WilliTourt/Orbi-SpaceMouse/README.md

# Orbi-SpaceMouse
Orbi - Dual mode 6DOF CAD Mouse for smooth translating, rotating and scaling, emulates a 3Dconnexion spacemouse.

Developing...

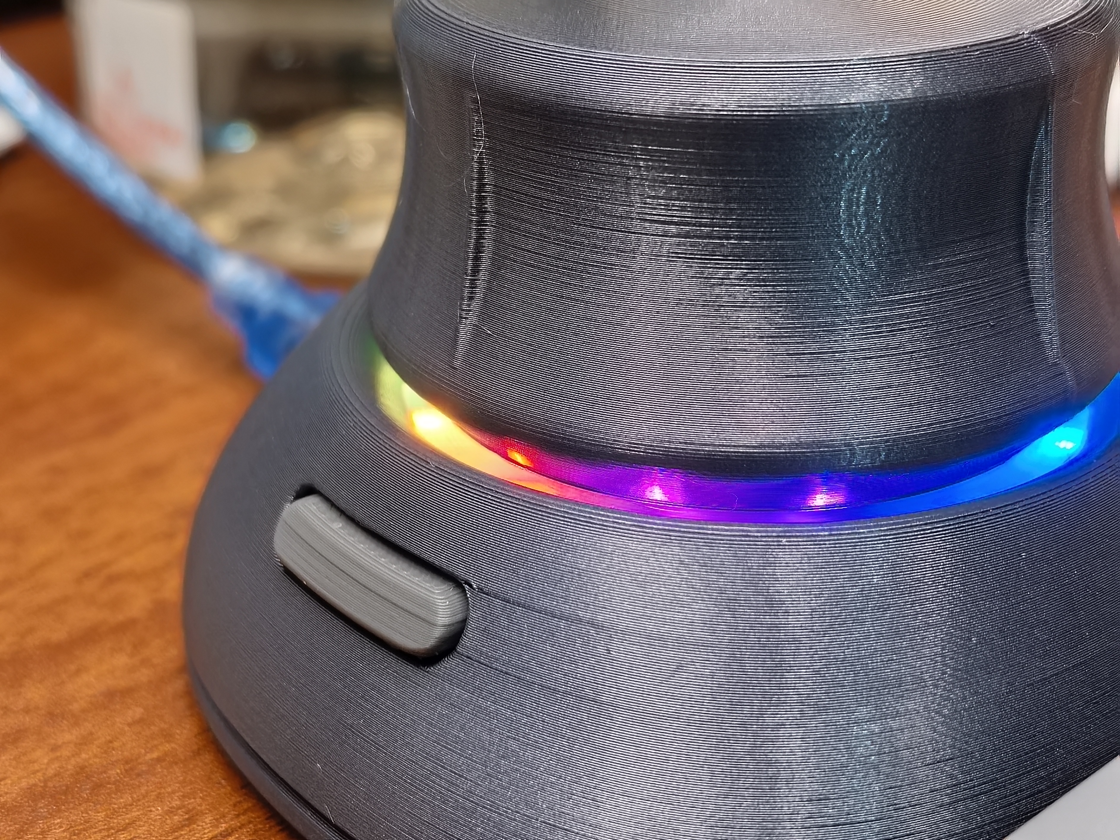
[picture p1: Orbi.jpg]
Orbi
