WilliTourt/Orbi-SpaceMouse/Hardware/PCB/Imgs/BottomBoard/Orbi BottomBoard  PCB 3D Bottom.png

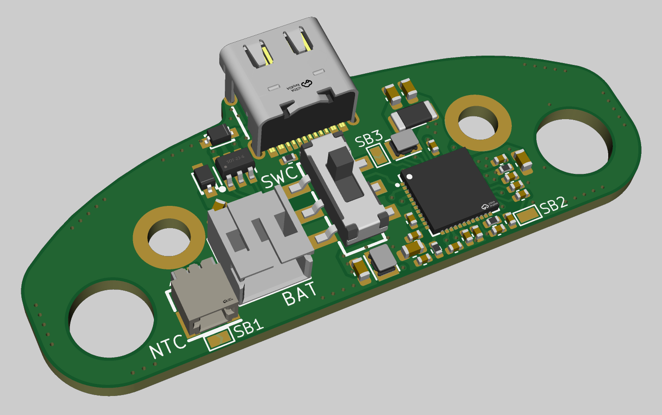
Hardware/PCB/Imgs/BottomBoard/Orbi BottomBoard PCB 3D Bottom.png
