WilliTourt/Orbi-SpaceMouse/Hardware/PCB/Imgs/BottomBoard/Orbi BottomBoard  PCB 3D Top.png

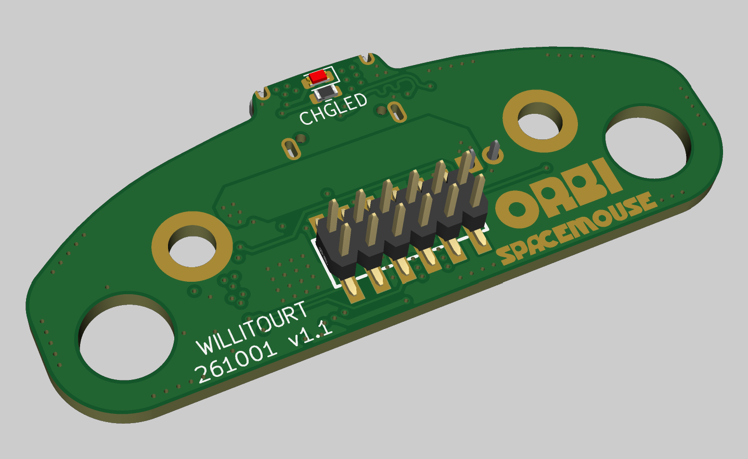
Hardware/PCB/Imgs/BottomBoard/Orbi BottomBoard PCB 3D Top.png
