WilliTourt/Orbi-SpaceMouse/Hardware/PCB/Imgs/BottomBoard/Orbi BottomBoard  PCB Bottom.png

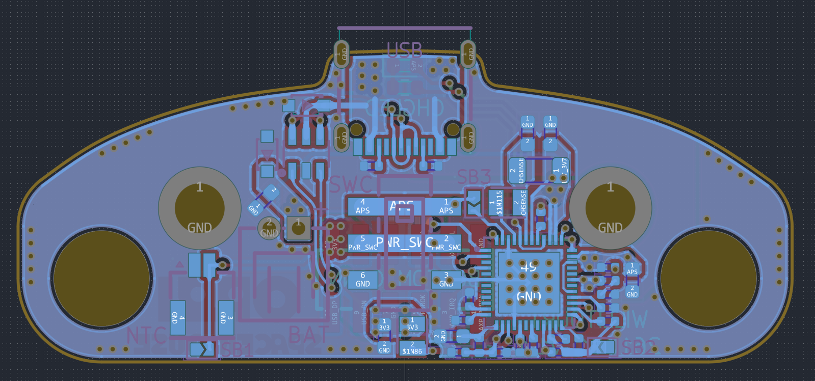
Hardware/PCB/Imgs/BottomBoard/Orbi BottomBoard PCB Bottom.png
