WilliTourt/Orbi-SpaceMouse/Hardware/PCB/Imgs/BottomBoard/Orbi BottomBoard  PCB Top.png

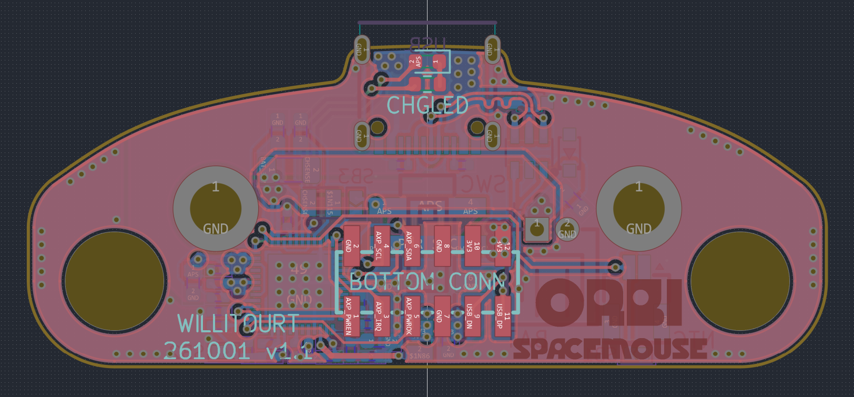
Hardware/PCB/Imgs/BottomBoard/Orbi BottomBoard PCB Top.png
