WilliTourt/Orbi-SpaceMouse/Hardware/PCB/Imgs/BottomBoard/Orbi BottomBoard Schem.png

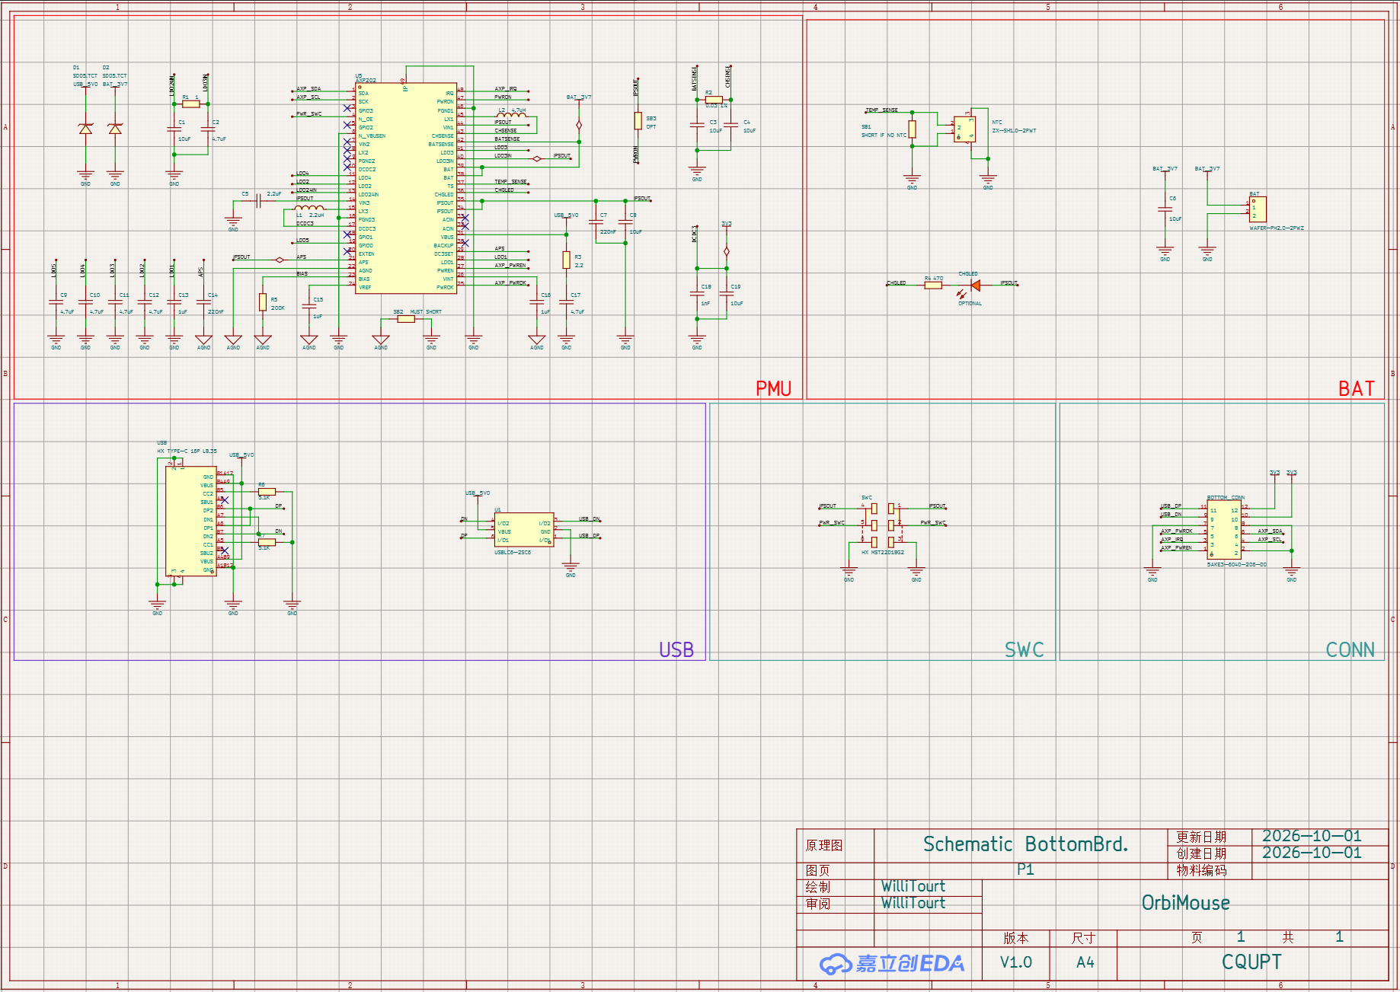
Hardware/PCB/Imgs/BottomBoard/Orbi BottomBoard Schem.png
