WilliTourt/Orbi-SpaceMouse/Hardware/PCB/Imgs/MomBoard/Orbi MomBoard  PCB 3D Bottom (Colorized Silkscreen).png

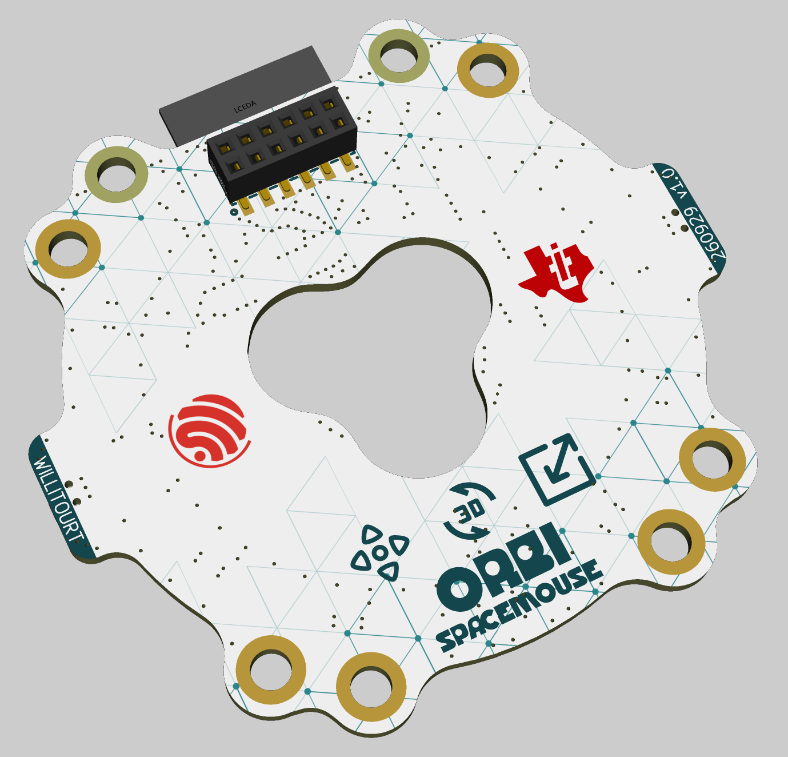
Hardware/PCB/Imgs/MomBoard/Orbi MomBoard PCB 3D Bottom (Colorized Silkscreen).png
