WilliTourt/Orbi-SpaceMouse/Hardware/PCB/Imgs/MomBoard/Orbi MomBoard  PCB 3D Bottom (Common Silkscreen).png

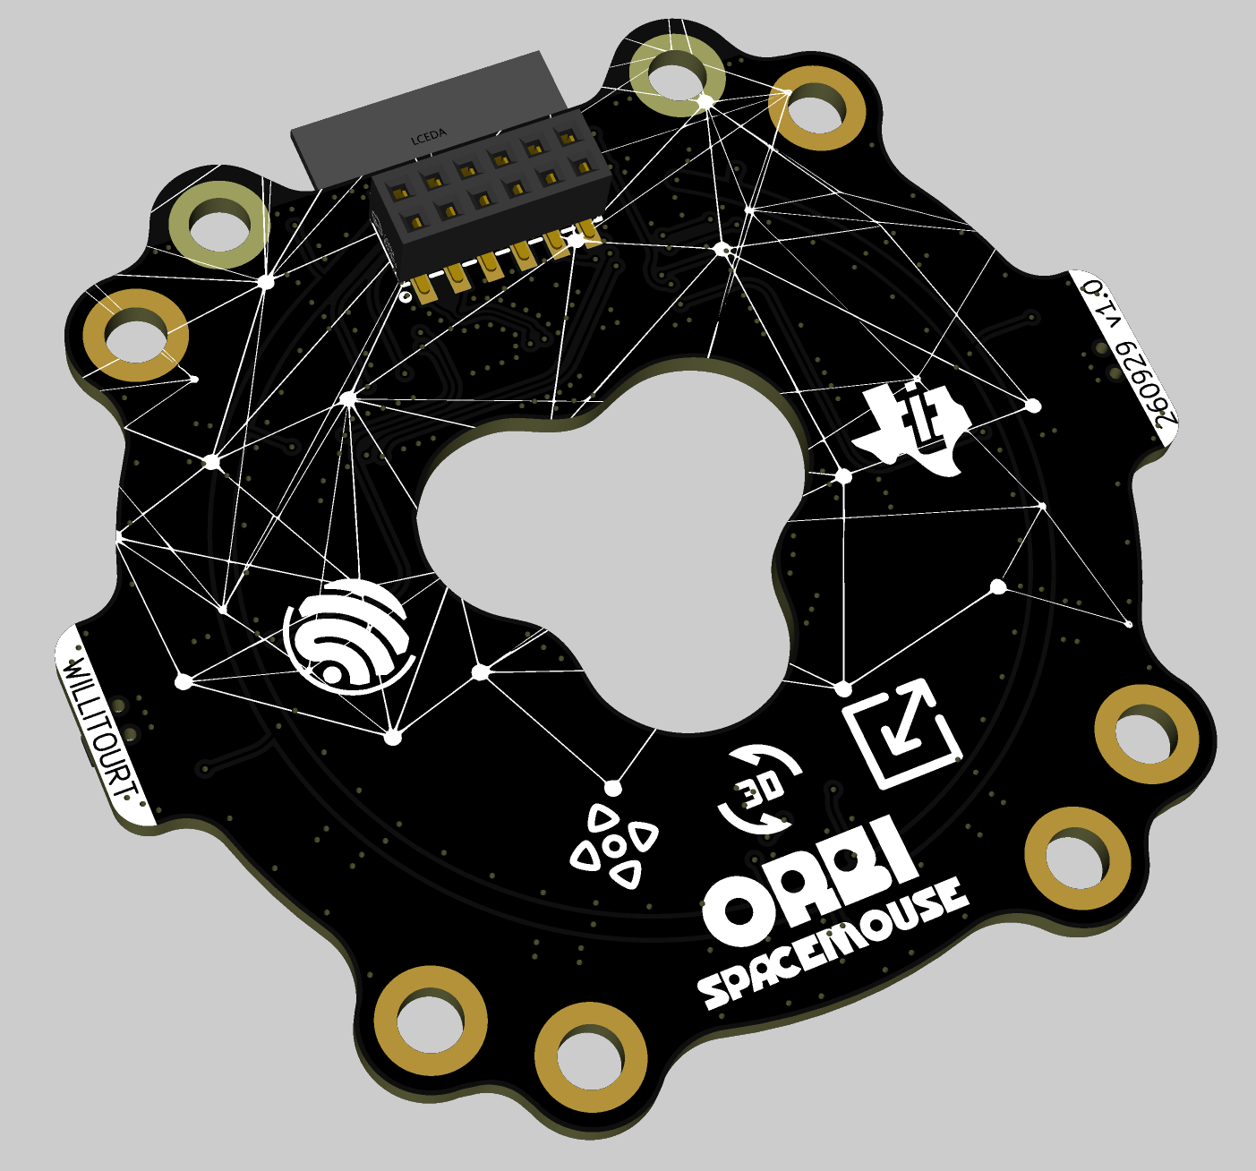
Hardware/PCB/Imgs/MomBoard/Orbi MomBoard PCB 3D Bottom (Common Silkscreen).png
