WilliTourt/Orbi-SpaceMouse/Hardware/PCB/Imgs/MomBoard/Orbi MomBoard  PCB 3D Top (Colorized Silkscreen).png

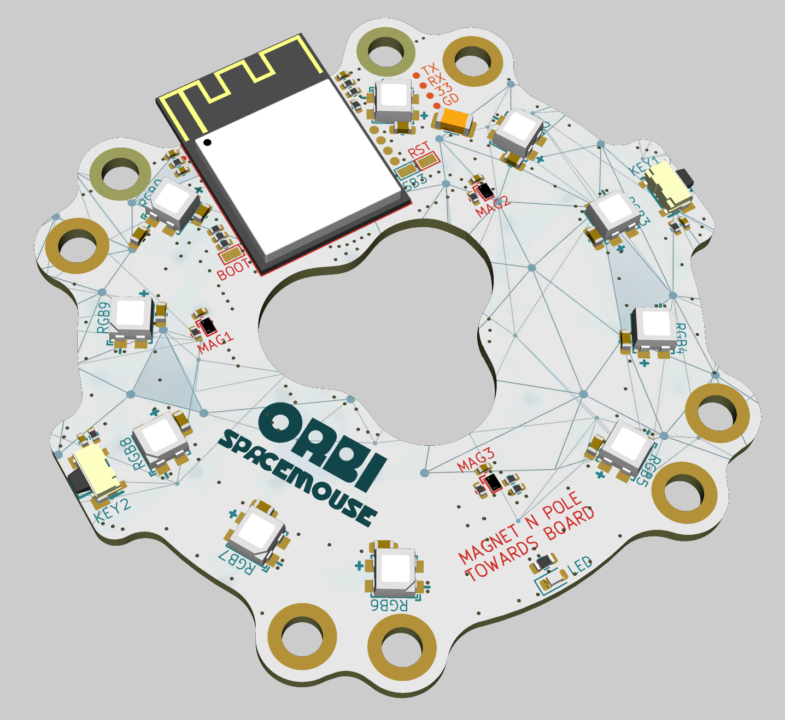
Hardware/PCB/Imgs/MomBoard/Orbi MomBoard PCB 3D Top (Colorized Silkscreen).png
