WilliTourt/Orbi-SpaceMouse/Hardware/PCB/Imgs/MomBoard/Orbi MomBoard  PCB 3D Top (Common Silkscreen).png

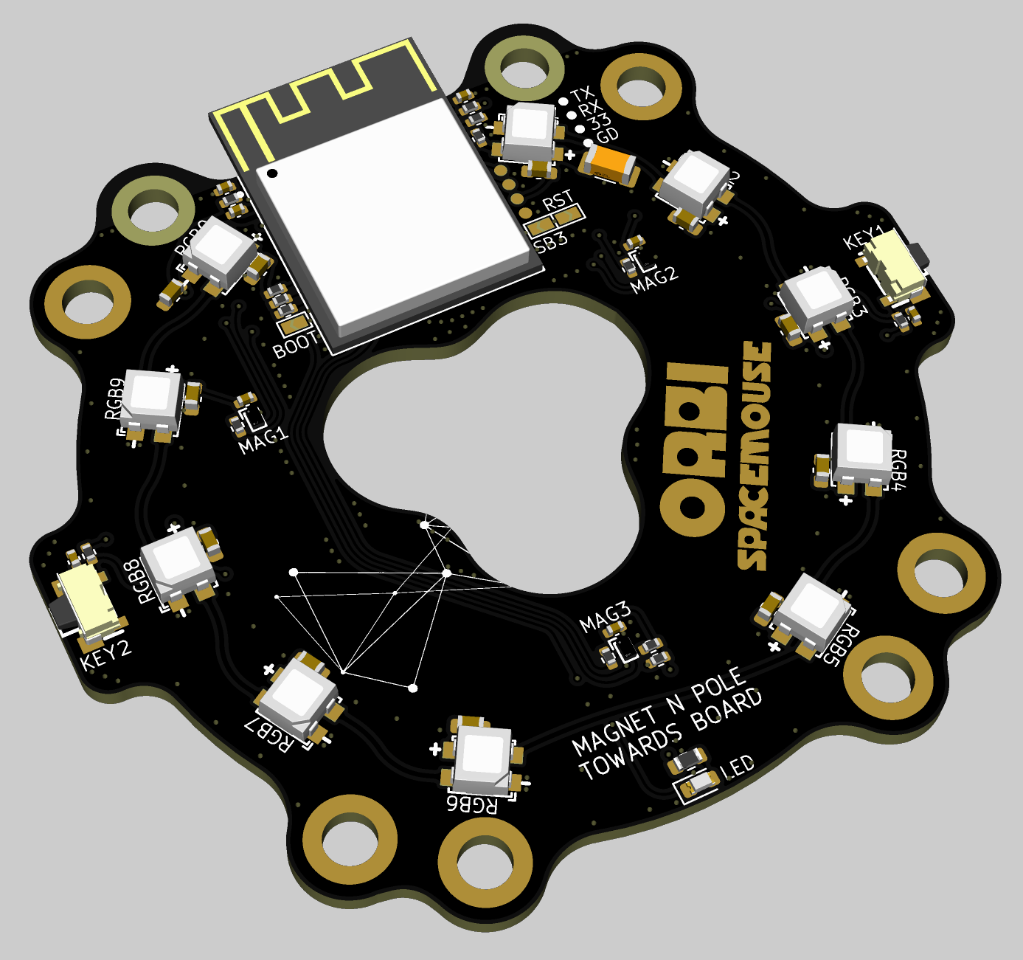
Hardware/PCB/Imgs/MomBoard/Orbi MomBoard PCB 3D Top (Common Silkscreen).png
