WilliTourt/Orbi-SpaceMouse/Hardware/PCB/Imgs/MomBoard/Orbi MomBoard  PCB Bottom (Colorized Silkscreen).png

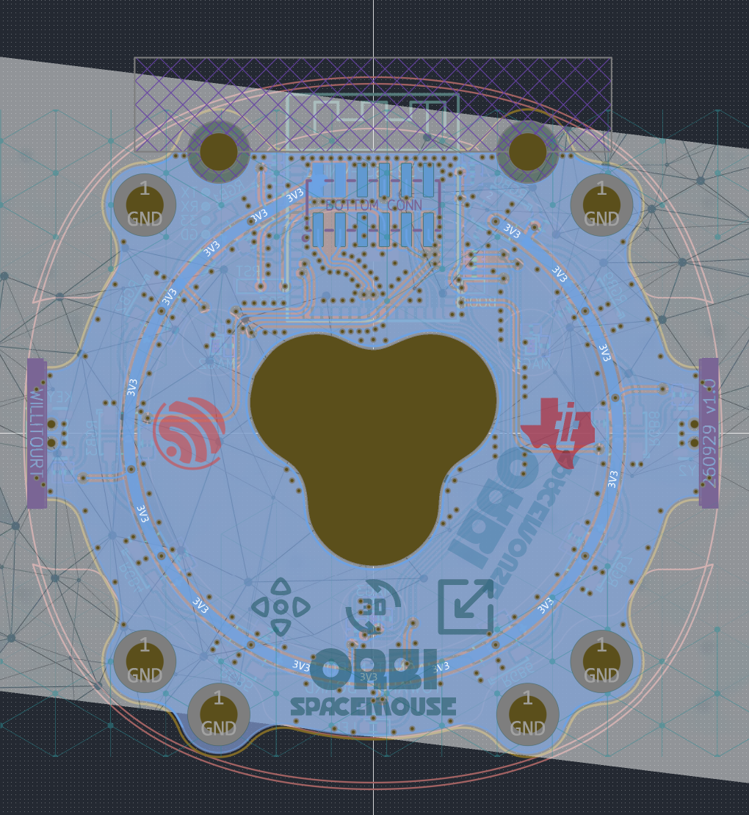
Hardware/PCB/Imgs/MomBoard/Orbi MomBoard PCB Bottom (Colorized Silkscreen).png
