WilliTourt/Orbi-SpaceMouse/Hardware/PCB/Imgs/MomBoard/Orbi MomBoard  PCB Bottom (Common Silkscreen).png

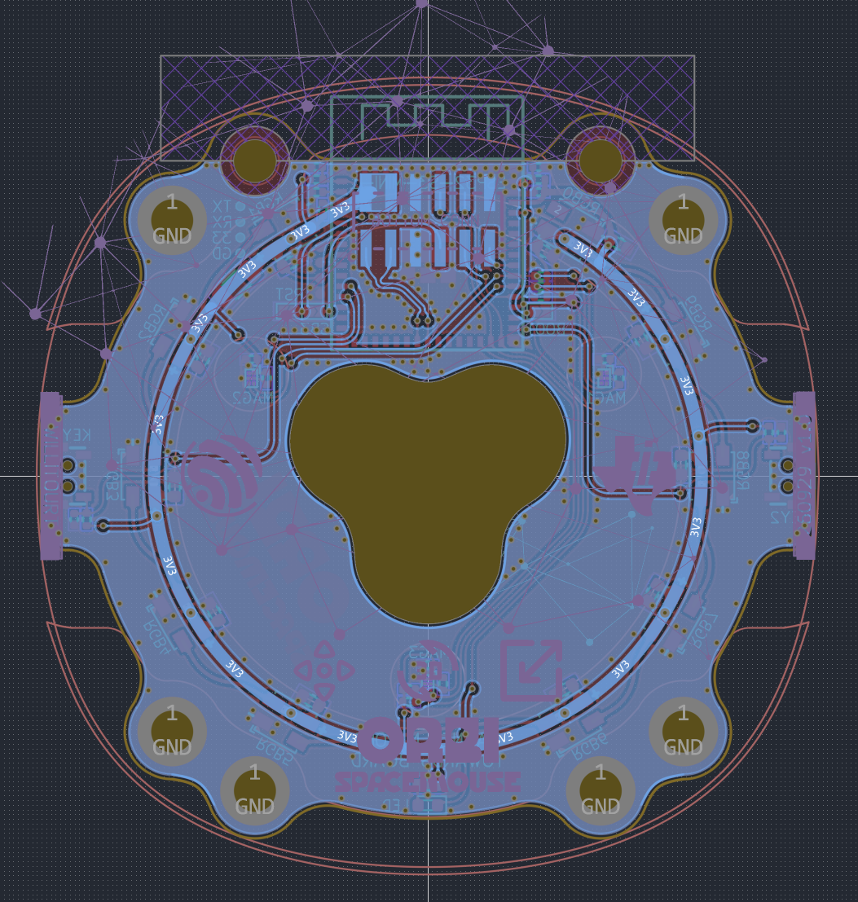
Hardware/PCB/Imgs/MomBoard/Orbi MomBoard PCB Bottom (Common Silkscreen).png
