WilliTourt/Orbi-SpaceMouse/Hardware/PCB/Imgs/MomBoard/Orbi MomBoard  PCB Top (Colorized Silkscreen).png

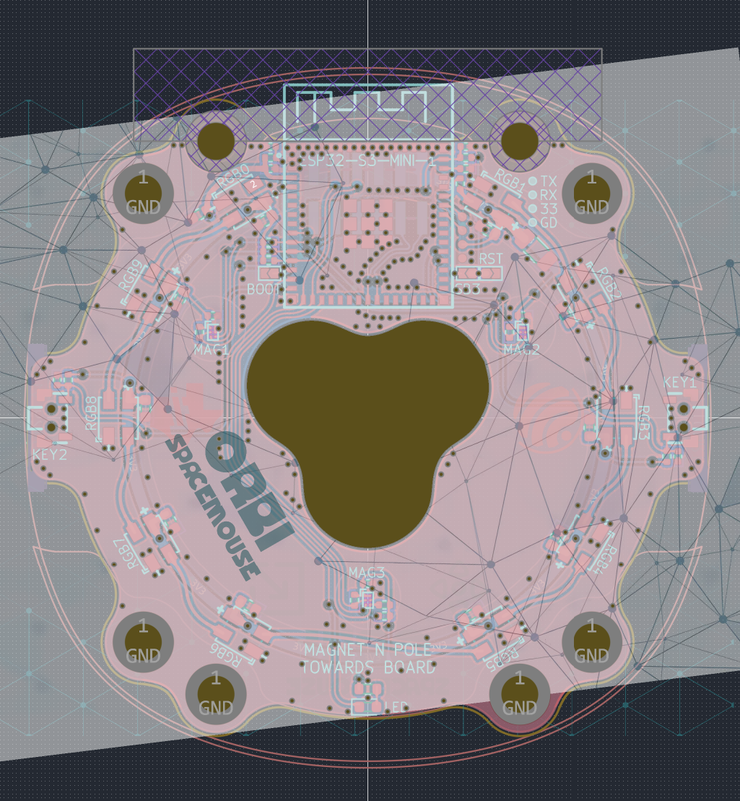
Hardware/PCB/Imgs/MomBoard/Orbi MomBoard PCB Top (Colorized Silkscreen).png
