WilliTourt/Orbi-SpaceMouse/Hardware/PCB/Imgs/MomBoard/Orbi MomBoard Schem.png

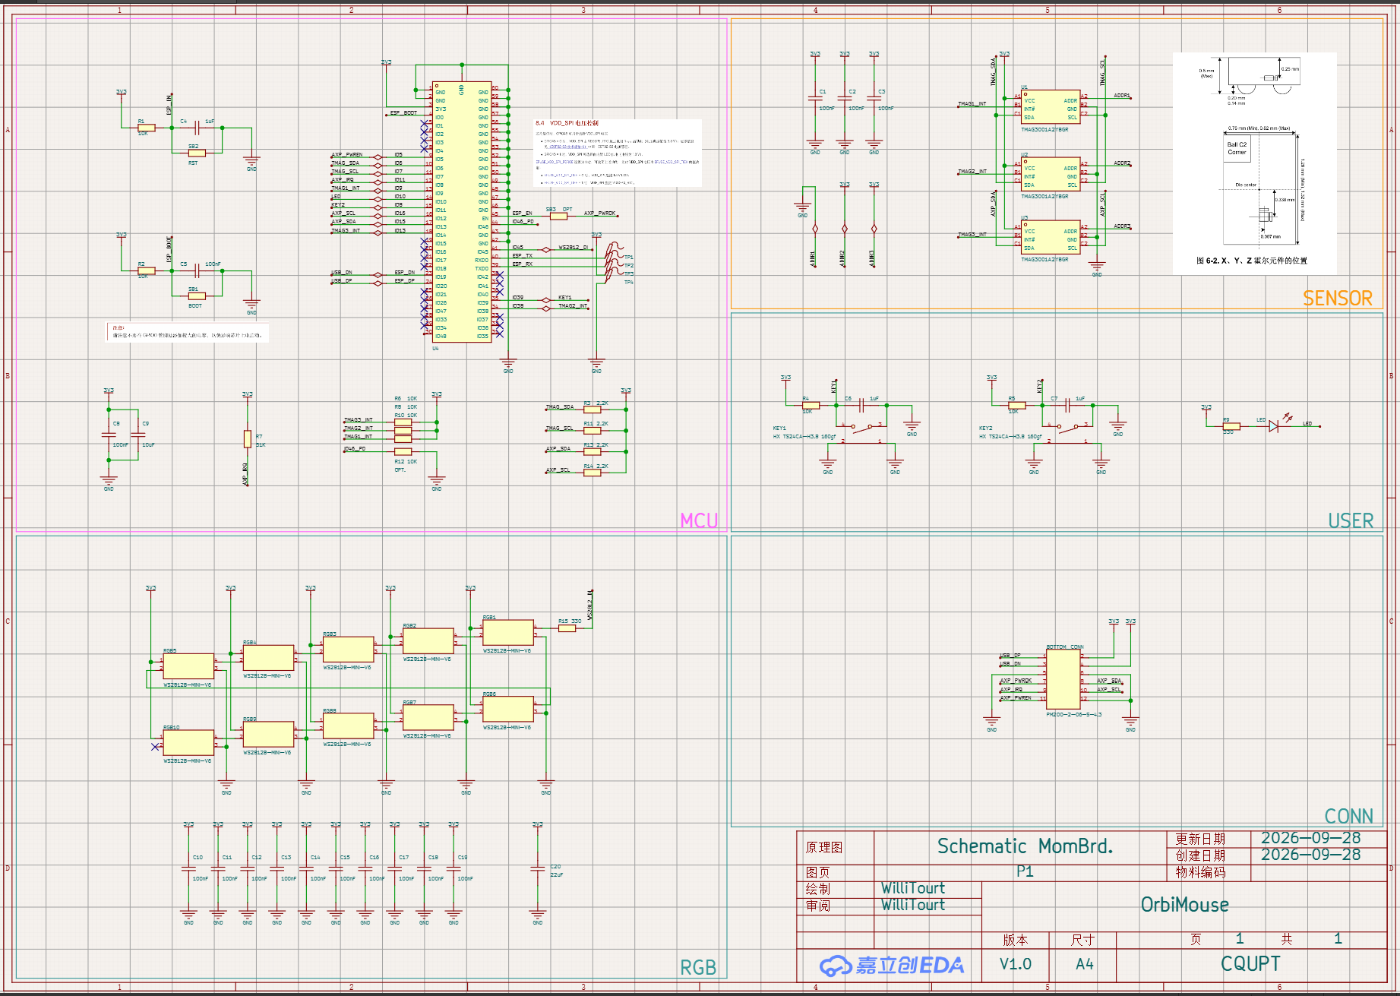
Hardware/PCB/Imgs/MomBoard/Orbi MomBoard Schem.png
