WilliTourt/Orbi-SpaceMouse/Hardware/PCB/Orbi PCB Silkscreen Assets/Abstract mesh.png

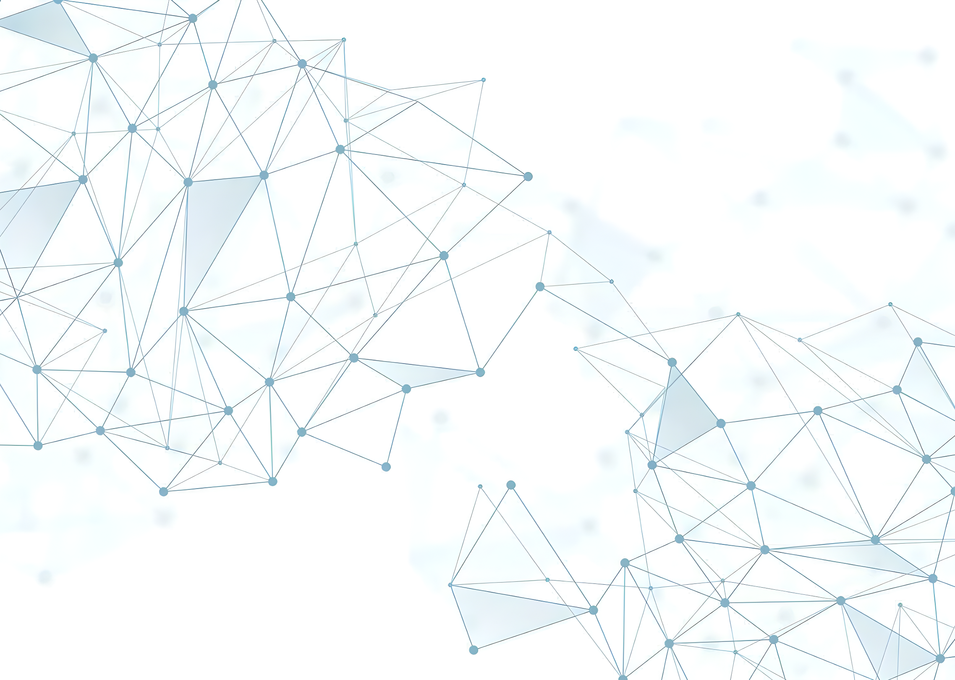
Hardware/PCB/Orbi PCB Silkscreen Assets/Abstract mesh.png
