WilliTourt/Orbi-SpaceMouse/Hardware/PCB/Orbi PCB Silkscreen Assets/dragging.png

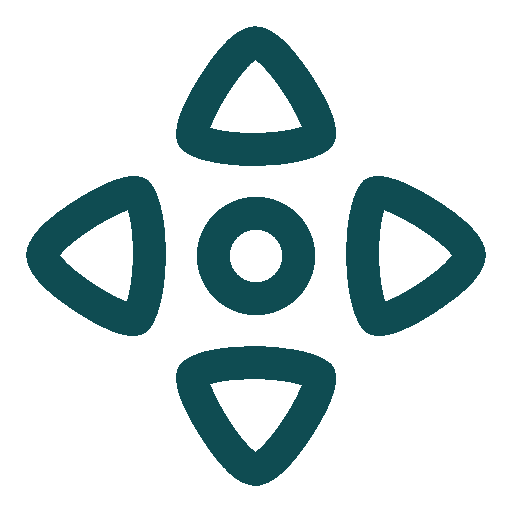
Hardware/PCB/Orbi PCB Silkscreen Assets/dragging.png
