WilliTourt/Orbi-SpaceMouse/Hardware/PCB/Orbi PCB Silkscreen Assets/ORBI.png

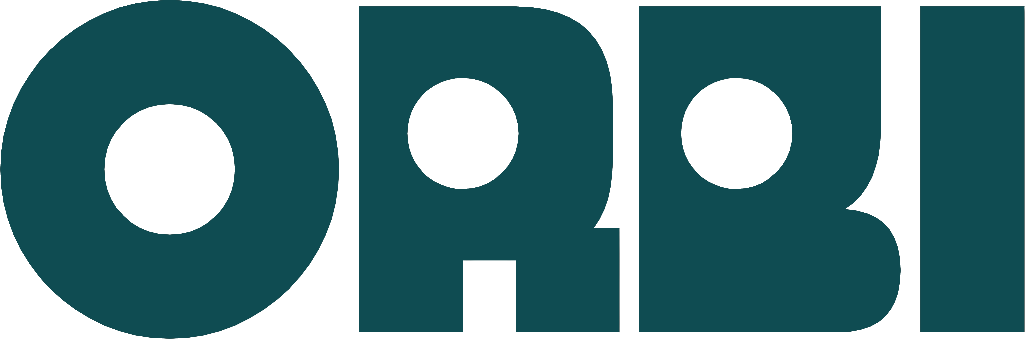
Hardware/PCB/Orbi PCB Silkscreen Assets/ORBI.png
