WilliTourt/Orbi-SpaceMouse/Hardware/PCB/Orbi PCB Silkscreen Assets/rotating.png

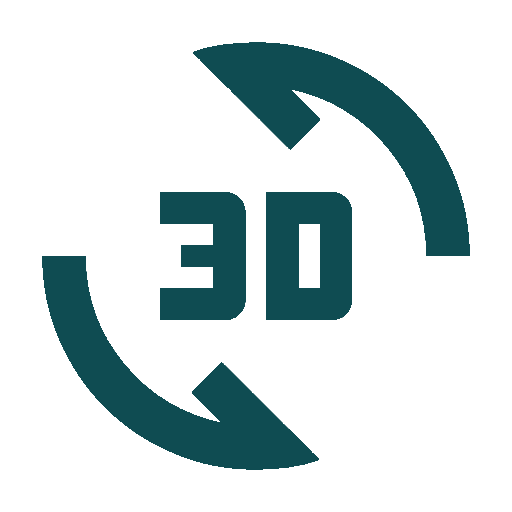
Hardware/PCB/Orbi PCB Silkscreen Assets/rotating.png
