WilliTourt/Orbi-SpaceMouse/Hardware/PCB/Orbi PCB Silkscreen Assets/scaling.png

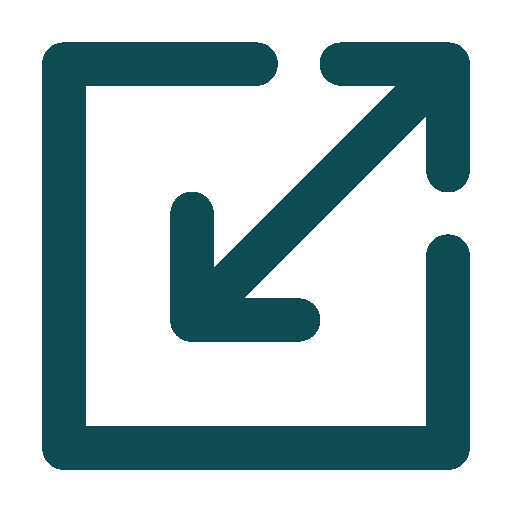
Hardware/PCB/Orbi PCB Silkscreen Assets/scaling.png
