WilliTourt/Orbi-SpaceMouse/Hardware/PCB/Orbi PCB Silkscreen Assets/triangle-mesh_278F96.png

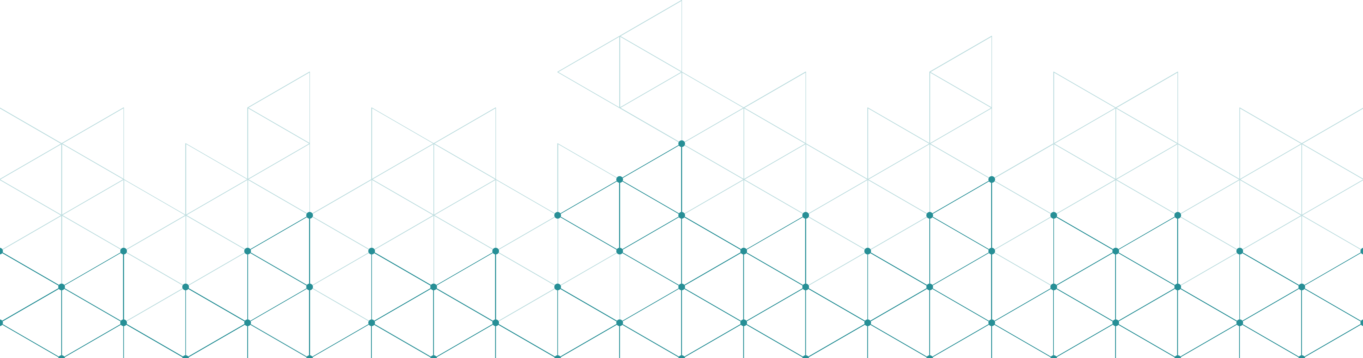
Hardware/PCB/Orbi PCB Silkscreen Assets/triangle-mesh_278F96.png
