WilliTourt/Orbi-SpaceMouse/Software/Orbi Algorithm/02 3D Magnetic Field Derivation/02 Handwriting.jpg

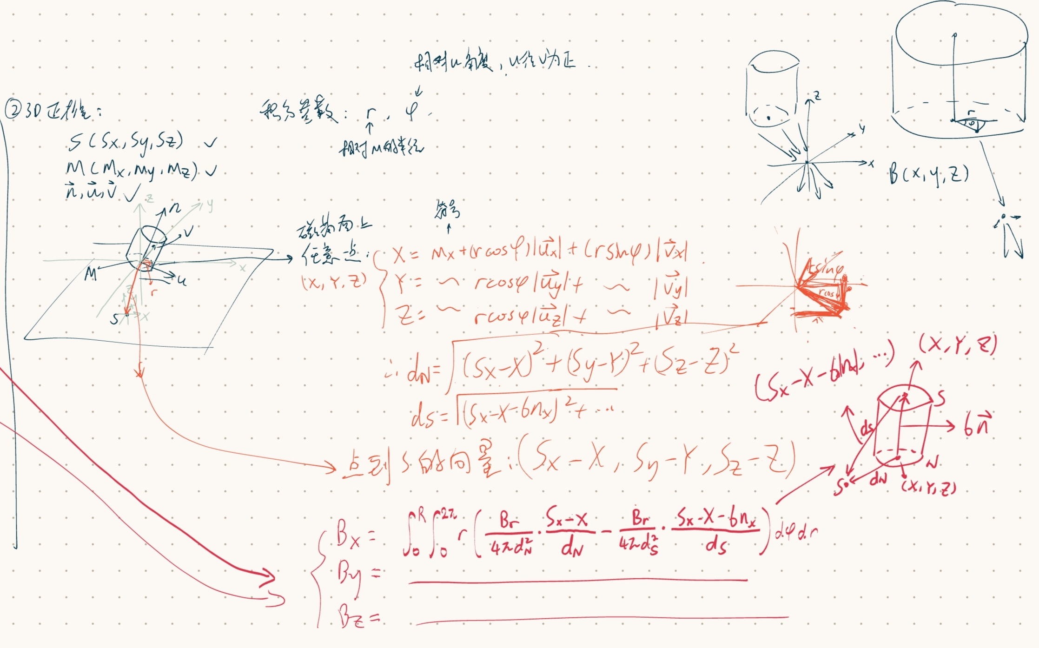
Software/Orbi Algorithm/02 3D Magnetic Field Derivation/02 Handwriting.jpg
