WilliTourt/Orbi-SpaceMouse/Software/Orbi Algorithm/Magnet position relative to sensor hall plane.jpg

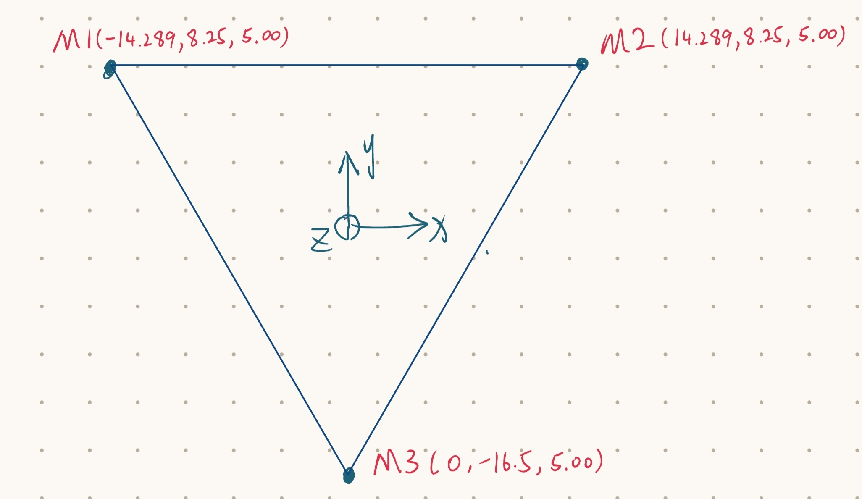
Software/Orbi Algorithm/Magnet position relative to sensor hall plane.jpg
