WilliTourt/Orbi-SpaceMouse/Software/Orbi Algorithm/Physics/01 Simplest Coaxial Derivation/01 Handwriting.jpg

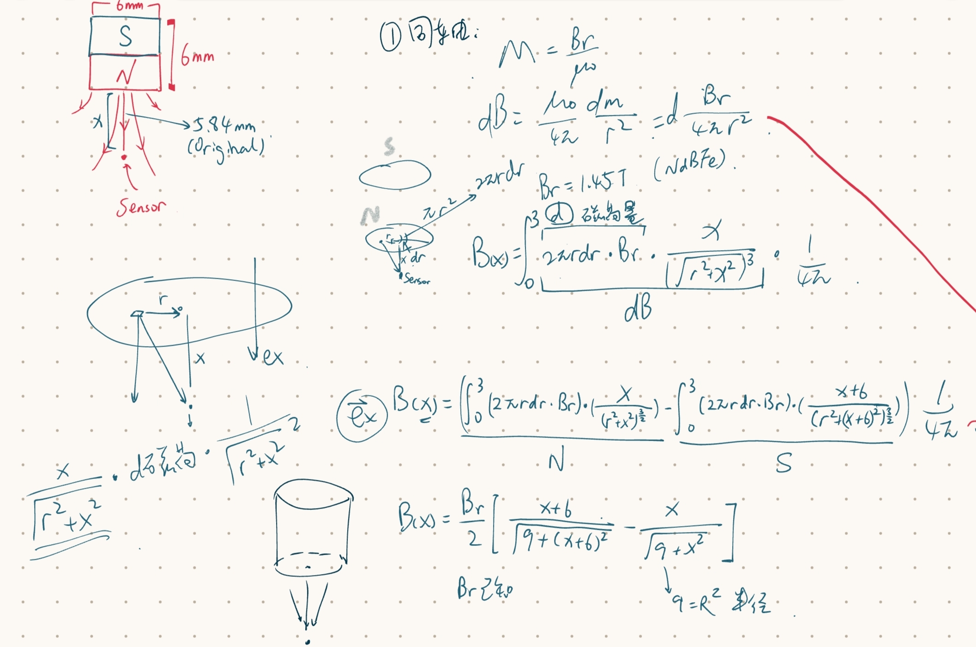
Software/Orbi Algorithm/Physics/01 Simplest Coaxial Derivation/01 Handwriting.jpg
