WilliTourt/Orbi-SpaceMouse/Hardware/BOMs/BOM_Orbi V1 Bottom Board_Schematic BottomBrd._2026-10-09.xlsx

No. | Quantity | Comment | Designator | Footprint | Value
1 | 1 | WAFER-PH2.0-2PWZ | BAT | CONN-TH_2P-P2.00_GP01-2001WR-2P
2 | 1 | 5AKE3-6040-206-D0 | BOTTOM_CONN | HDR-SMD_12P-P2.00-V-M-R2-C6-LS6.5-EH-1
3 | 6 | 10uF | C1,C3,C4,C6,C8,C19 | C_0603_1608Metric | 10uF
4 | 6 | 4.7uF | C2,C9,C10,C11,C12,C17 | C_0402_1005Metric | 4.7uF
5 | 1 | 2.2uF | C5 | C_0402_1005Metric | 2.2uF
6 | 2 | 220nF | C7,C14 | C_0402_1005Metric | 220nF
7 | 3 | 1uF | C13,C15,C16 | C_0402_1005Metric | 1uF
8 | 1 | 1nF | C18 | C_0402_1005Metric | 1nF
9 | 1 | OPTIONAL | CHGLED | LED_0603_1608Metric
10 | 2 | SD05.TCT | D1,D2 | SOD-323_L1.7-W1.3-LS2.5-RD
11 | 1 | 2.2uH | L1 | IND-SMD_L2.0-W1.6 | 2.2uH
12 | 1 | 4.7uH | L2 | IND-SMD_L2.0-W1.6 | 4.7uH
13 | 1 | ZX-SH1.0-2PWT | NTC | CONN-SMD_2P-P1.00_HX-1.0-2P-WT
14 | 1 | 1 | R1 | R_0402_1005Metric | 1
15 | 1 | 0.03 1% | R2 | R_1206_3216Metric | 0.03 1%
16 | 1 | 2.2 | R3 | R_0402_1005Metric | 2.2
17 | 1 | 470 | R4 | R_0603_1608Metric | 470
18 | 1 | 200K | R5 | R_0402_1005Metric | 200K
19 | 2 | 5.1K | R6,R7 | R_0402_1005Metric | 5.1K
20 | 1 | HX MST22D18G2 | SWC | SW-SMD_MST22D18G2
21 | 1 | USBLC6-2SC6 | U1 | SOT-23-6_L2.9-W1.6-P0.95-LS2.8-BL
22 | 1 | AXP202 | U5 | QFN-48_L6.0-W6.0-P0.40-TL-EP4.1
23 | 1 | TYPE-C 16P L8.00 CH=1.6 | USB | USB-C-SMD_HC-TYPE-C-16P-CH3.18-3A-02
24 | 6 | Magnet D6*3mm
25 | 1 | 803160 LiPo 3.7V
