WilliTourt/Orbi-SpaceMouse/Hardware/BOMs/BOM_Orbi V1 Motherboard_Schematic MomBrd._2026-10-09.xlsx

No. | Quantity | Comment | Designator | Footprint | Value
1 | 1 | PM200-2-06-S-4.3 | BOTTOM_CONN | HDR-SMD_12P-P2.00-V-F-R2-C6-LS6.5-1
2 | 5 | 100nF | C1,C2,C3,C5,C8 | C_0402_1005Metric | 100nF
3 | 3 | 1uF | C4,C6,C7 | C_0402_1005Metric | 1uF
4 | 1 | 10uF | C9 | C_0603_1608Metric | 10uF
5 | 10 | 100nF | C10,C11,C12,C13,C14,C15,C16,C17,C18,C19 | C_0603_1608Metric | 100nF
6 | 1 | 22uF | C20 | C_1206_3216Metric | 22uF
7 | 2 | TS24CA-H3.8 160gf | KEY1,KEY2 | SW-SMD_TS24CA
8 | 1 | LED0603 | LED | LED_0603_1608Metric
9 | 8 | 10K | R1,R2,R4,R5,R6,R8,R10,R12 | R_0402_1005Metric | 10K
10 | 4 | 2.2K | R3,R11,R13,R14 | R_0402_1005Metric | 2.2K
11 | 1 | 51K | R7 | R_0402_1005Metric | 51K
12 | 1 | 330 | R9 | R_0603_1608Metric | 330
13 | 1 | 330 | R15 | R_0402_1005Metric | 330
14 | 10 | WS2812B-MINI-V6 | RGB1,RGB2,RGB3,RGB4,RGB5,RGB6,RGB7,RGB8,RGB9,RGB10 | LED-SMD_4P-L3.5-W3.5-TL_WS2812B
15 | 3 | TMAG3001A2YBGR | U1,U2,U3 | BGA-6_L1.3-W0.8-P0.40-TL_PTMAG3001A2YBGR
16 | 1 | ESP32-S3-MINI-1-N8 | U4 | BULETM-SMD_ESP32-S3-MINI-1-N8 | 2.4GHz
