WilliTourt/Orbi-SpaceMouse/Hardware/3D/SolidWorks/DXF/Orbi_MomPCB Border.DXF

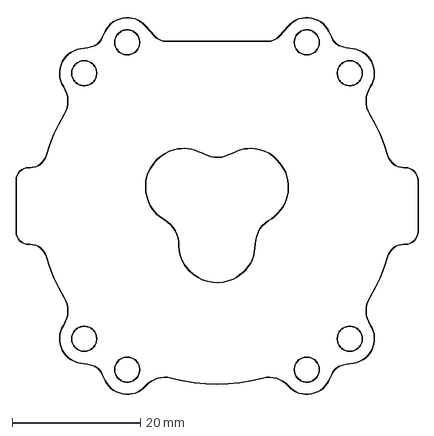
[picture p24: CAD file, 2026-10-08]
Hardware/3D/SolidWorks/DXF/Orbi_MomPCB Border.DXF
62.7 x 59.1 mm
