WilliTourt/Orbi-SpaceMouse/Hardware/3D/SolidWorks/Orbi_PowerSwitch.SLDPRT

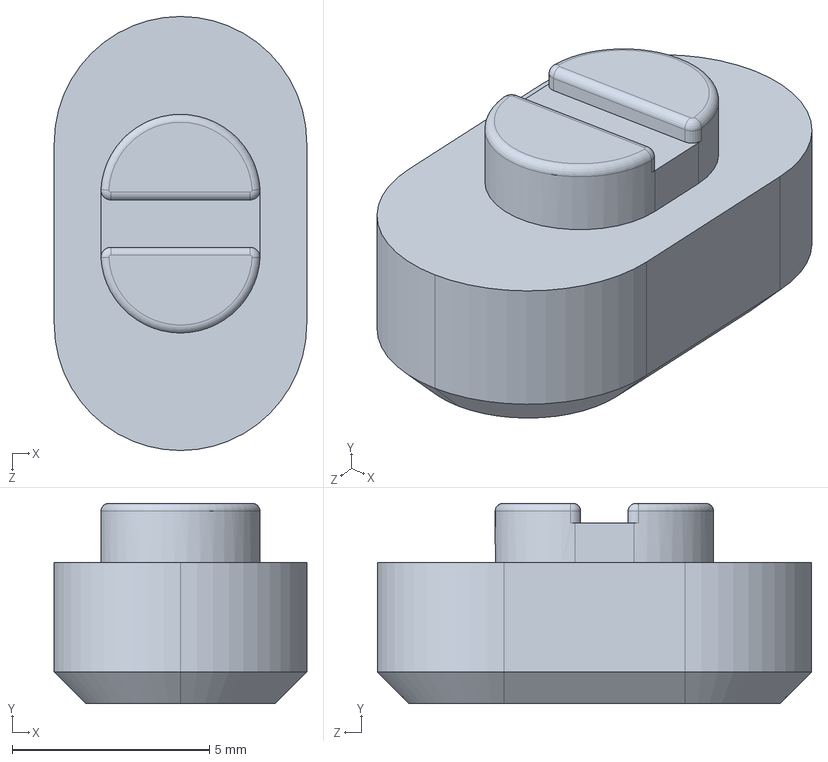
[picture p25: CAD file, 2026-10-12]
Hardware/3D/SolidWorks/Orbi_PowerSwitch.SLDPRT
6.40 x 5.08 x 11.0 mm
