WilliTourt/Orbi-SpaceMouse/Hardware/3D/STEP and 3MF/Orbi_BaseShell.STEP

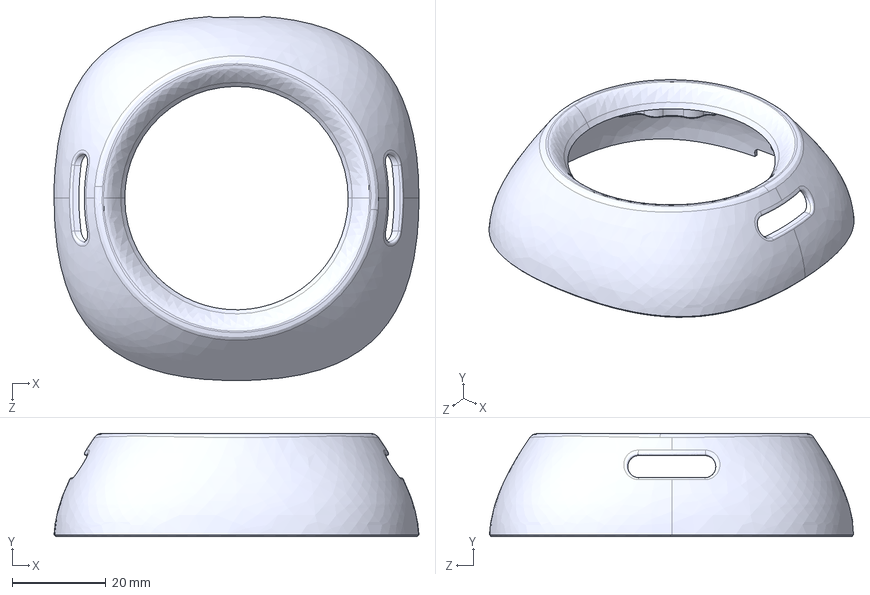
[picture p26: CAD file, 2026-10-12]
Hardware/3D/STEP and 3MF/Orbi_BaseShell.STEP
77.8 x 22.0 x 77.6 mm
