WilliTourt/Orbi-SpaceMouse/Hardware/PCB/DXF_MomBoard Colorized Silkscreen v1.1_AutoCAD2007.dxf

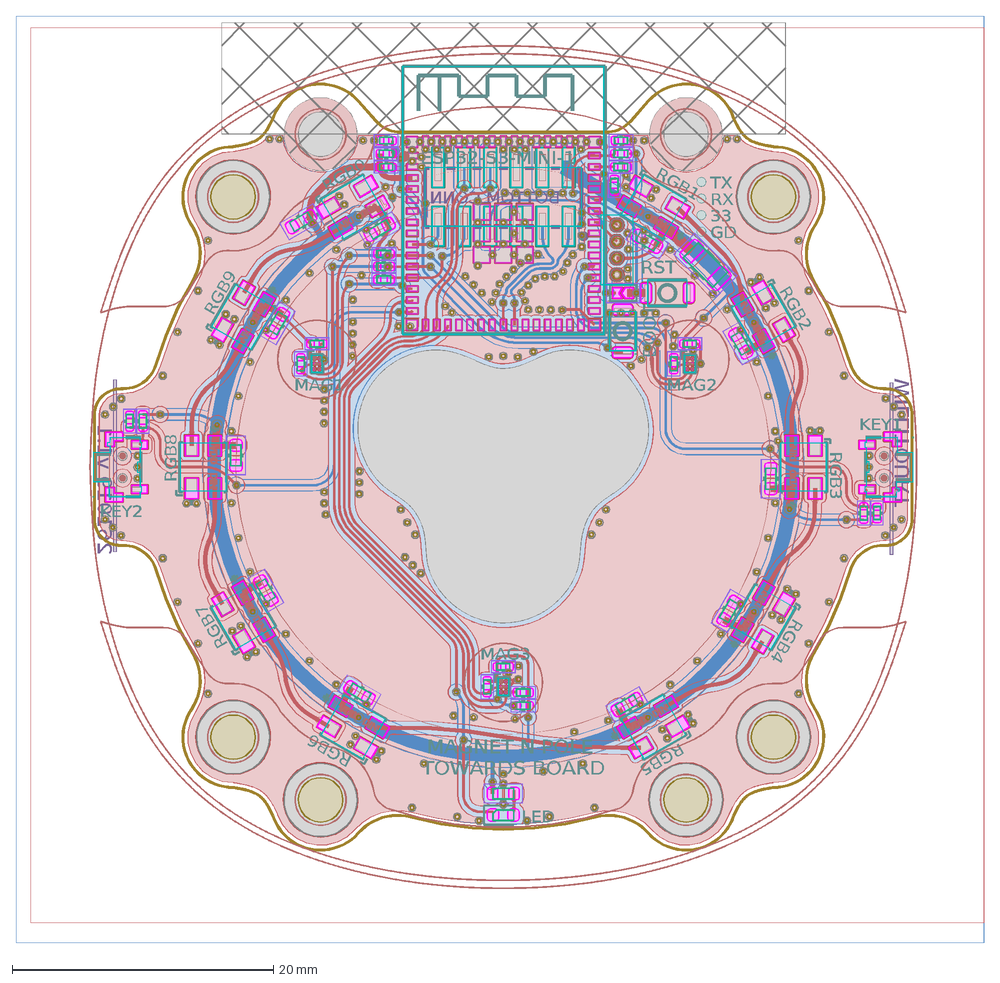
[picture p27: CAD file, 2026-11-10]
Hardware/PCB/DXF_MomBoard Colorized Silkscreen v1.1_AutoCAD2007.dxf
WILLITOURT
261019 v1.1
BOTTOM CONN
MAGNET N POLE
TOWARDS BOARD
TX
RX
33
GD
KEY1
KEY2
RGB1
RGB2
RGB3
RGB4
RGB5
RGB6
RGB7
RGB8
RGB9
RGB0
MAG1
MAG2
MAG3
ESP32-S3-MINI-1
LED
BOOT
RST
