WilliTourt/Orbi-SpaceMouse/Hardware/3D/SolidWorks/DXF/Orbi_MomPCB Hall Sensor Position.DXF

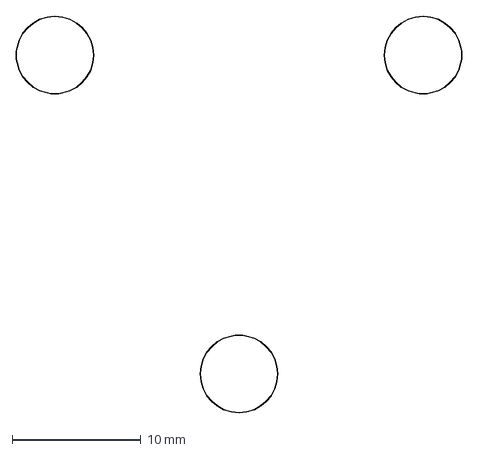
[picture p28: CAD file, 2026-10-08]
Hardware/3D/SolidWorks/DXF/Orbi_MomPCB Hall Sensor Position.DXF
34.6 x 30.8 mm
