WilliTourt/Orbi-SpaceMouse/Hardware/3D/SolidWorks/Orbi_Joystick.SLDPRT

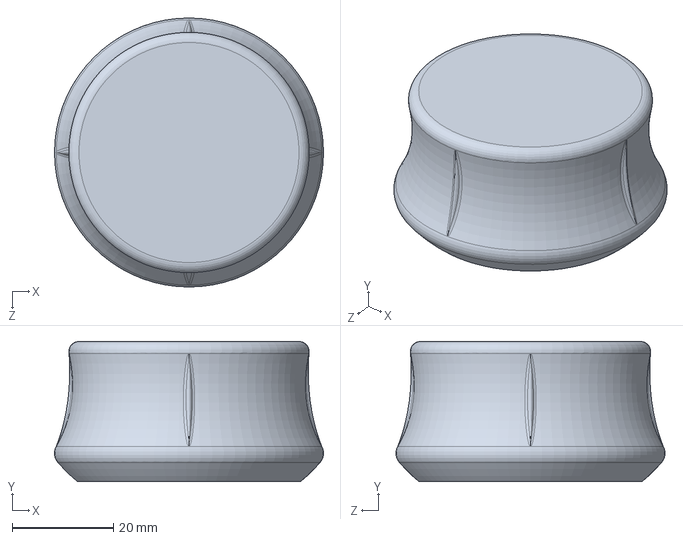
[picture p29: CAD file, 2026-10-12]
Hardware/3D/SolidWorks/Orbi_Joystick.SLDPRT
53.2 x 27.7 x 53.2 mm
