WilliTourt/Orbi-SpaceMouse/Hardware/3D/SolidWorks/DXF/Orbi_Available MomPCB Layout Area.DXF

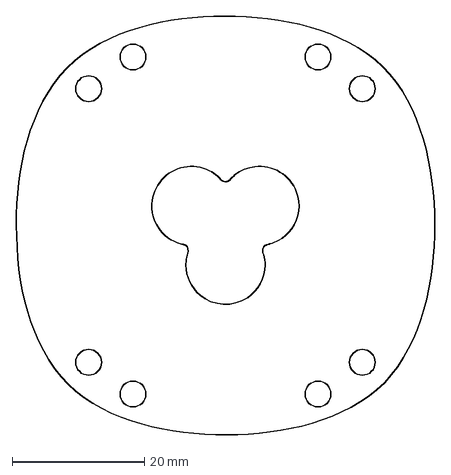
[picture p30: CAD file, 2026-10-08]
Hardware/3D/SolidWorks/DXF/Orbi_Available MomPCB Layout Area.DXF
63.3 x 63.3 mm
