WilliTourt/Orbi-SpaceMouse/Hardware/3D/SolidWorks/Orbi_Base.SLDPRT

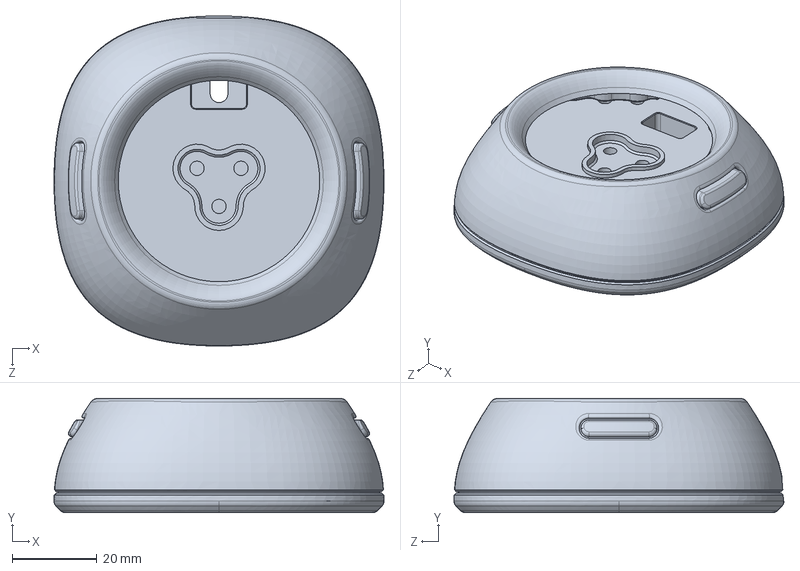
[picture p31: CAD file, 2026-10-12]
Hardware/3D/SolidWorks/Orbi_Base.SLDPRT
78.0 x 27.0 x 78.0 mm
