WilliTourt/Orbi-SpaceMouse/Hardware/3D/STEP and 3MF/Orbi_Diffuser.STEP

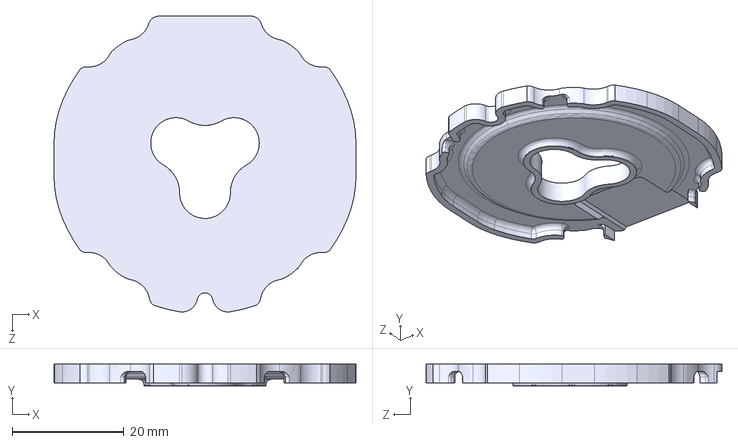
[picture p32: CAD file, 2026-10-12]
Hardware/3D/STEP and 3MF/Orbi_Diffuser.STEP
54.0 x 3.90 x 52.9 mm
