WilliTourt/Orbi-SpaceMouse/Hardware/3D/SolidWorks/DXF/Orbi_MomPCB Component Clearance.DXF

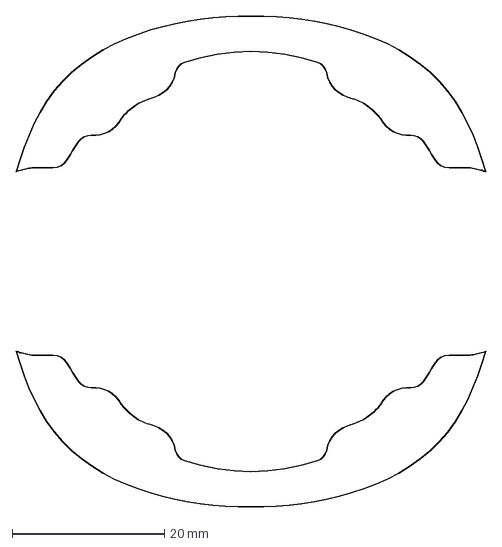
[picture p33: CAD file, 2026-10-08]
Hardware/3D/SolidWorks/DXF/Orbi_MomPCB Component Clearance.DXF
61.7 x 64.5 mm
