WilliTourt/Orbi-SpaceMouse/Hardware/3D/STEP and 3MF/Orbi_BaseButton.STEP

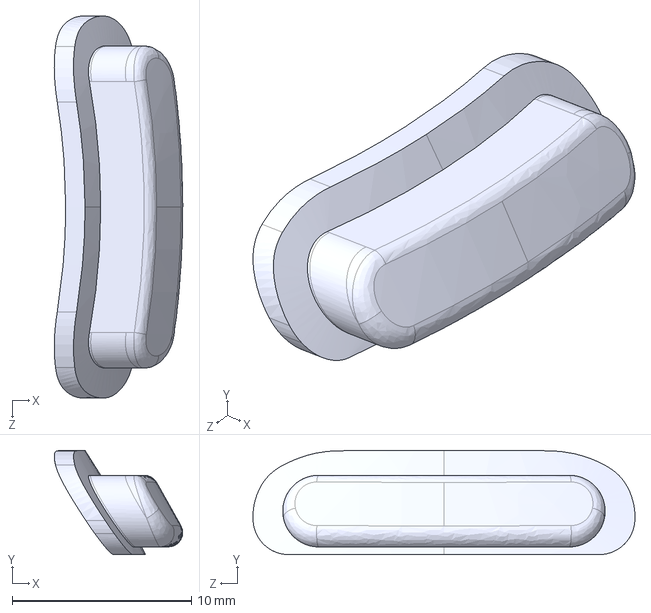
[picture p34: CAD file, 2026-10-12]
Hardware/3D/STEP and 3MF/Orbi_BaseButton.STEP
7.18 x 5.82 x 21.3 mm
