WilliTourt/Orbi-SpaceMouse/Hardware/3D/SolidWorks/DXF/Orbi_BottomPCB Border.DXF

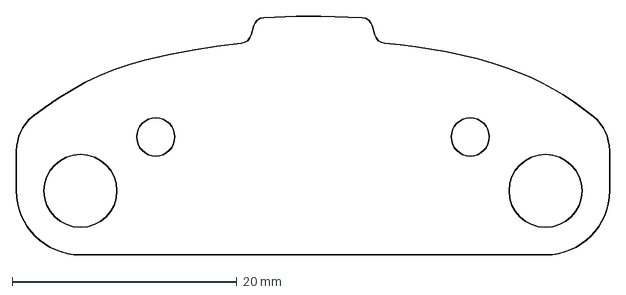
[picture p35: CAD file, 2026-10-08]
Hardware/3D/SolidWorks/DXF/Orbi_BottomPCB Border.DXF
52.8 x 21.3 mm
