WilliTourt/Orbi-SpaceMouse/Hardware/3D/SolidWorks/Orbi_Joystick_Spring.SLDPRT

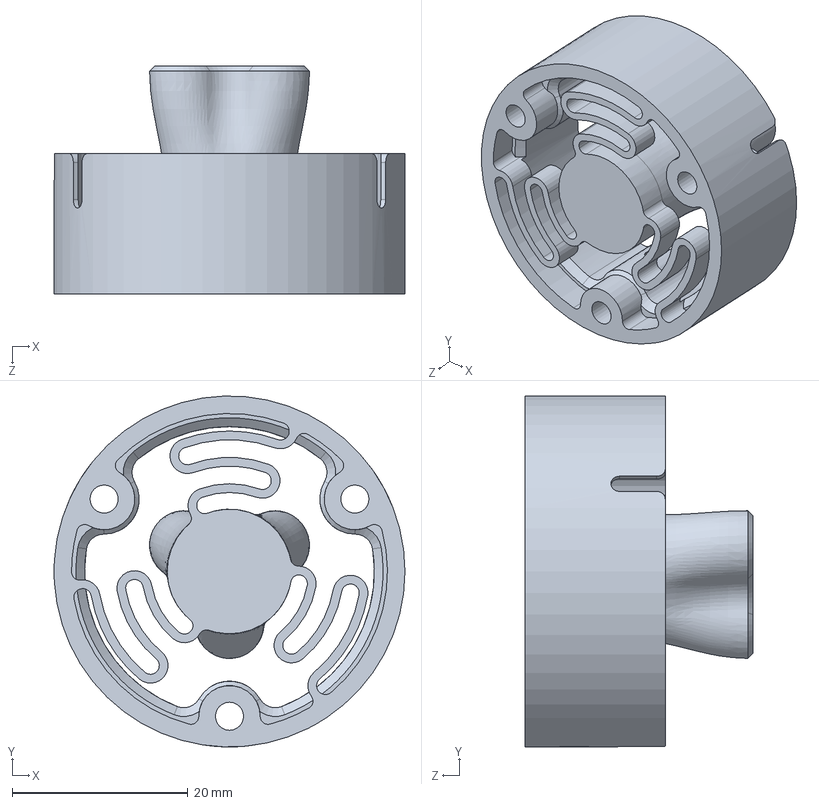
[picture p36: CAD file, 2026-10-08]
Hardware/3D/SolidWorks/Orbi_Joystick_Spring.SLDPRT
40.0 x 40.0 x 26.0 mm
