WilliTourt/Orbi-SpaceMouse/Hardware/3D/STEP and 3MF/Orbi_BaseCover_For3DPrinting.STEP

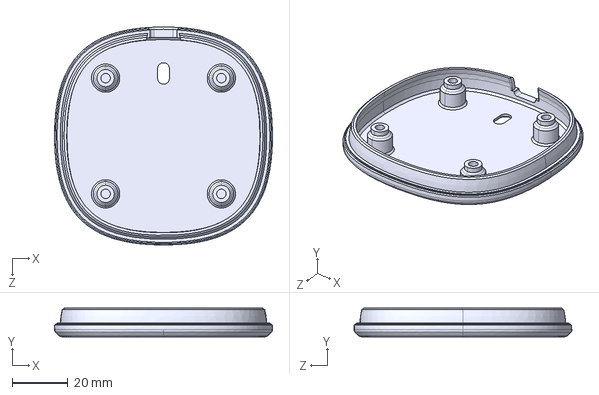
[picture p37: CAD file, 2026-10-08]
Hardware/3D/STEP and 3MF/Orbi_BaseCover_For3DPrinting.STEP
78.0 x 10.2 x 78.0 mm
