WilliTourt/Orbi-SpaceMouse/Hardware/3D/STEP and 3MF/Orbi_JoystickSpring.STEP

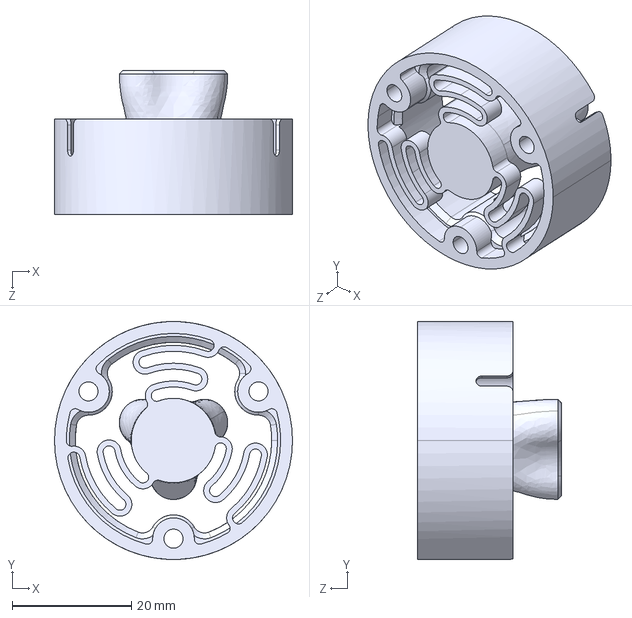
[picture p38: CAD file, 2026-10-08]
Hardware/3D/STEP and 3MF/Orbi_JoystickSpring.STEP
40.0 x 40.0 x 24.2 mm
