WilliTourt/Orbi-SpaceMouse/Hardware/3D/STEP and 3MF/Orbi_BaseCover.STEP

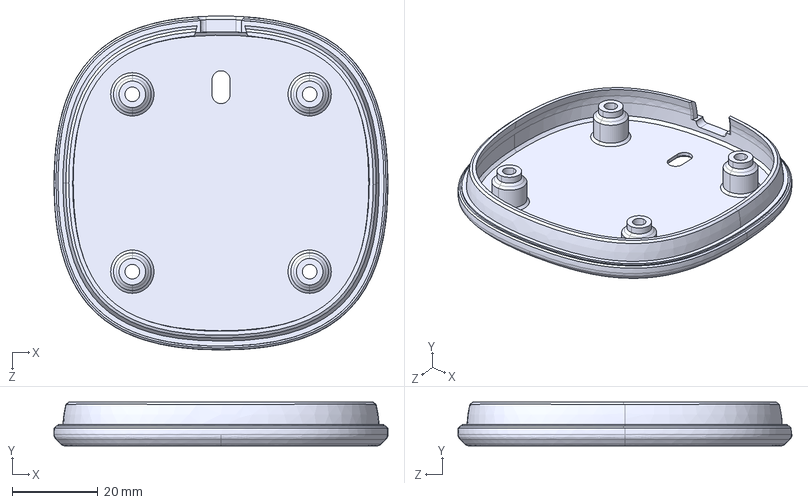
[picture p39: CAD file, 2026-10-08]
Hardware/3D/STEP and 3MF/Orbi_BaseCover.STEP
78.0 x 10.2 x 78.0 mm
