WilliTourt/Orbi-SpaceMouse/Hardware/3D/STEP and 3MF/Orbi_BaseAluminumWeight.STEP

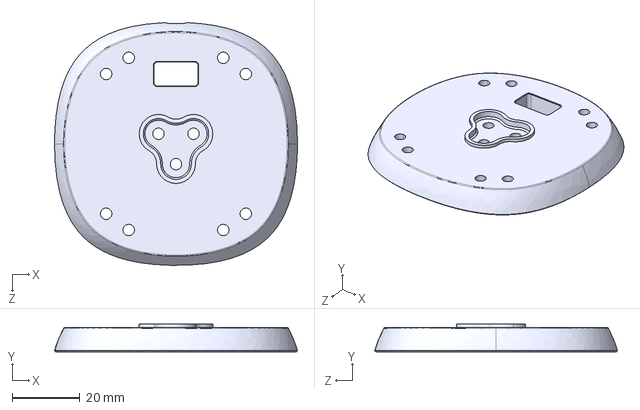
[picture p40: CAD file, 2026-10-08]
Hardware/3D/STEP and 3MF/Orbi_BaseAluminumWeight.STEP
72.0 x 8.17 x 71.9 mm
