WilliTourt/Orbi-SpaceMouse/Hardware/3D/SolidWorks/Orbi Assemble.SLDASM

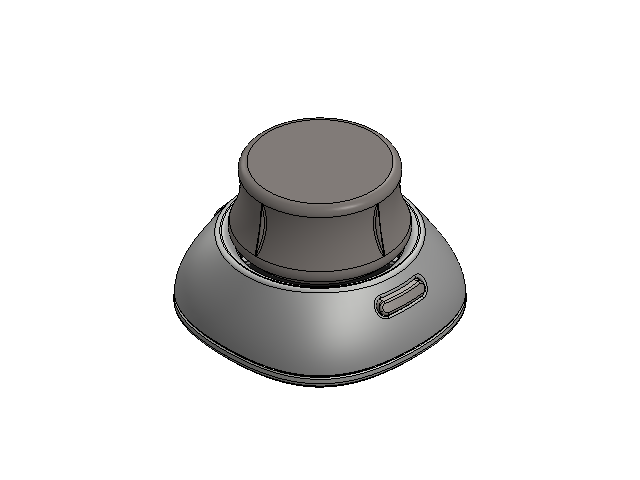
[picture p41: CAD file, 2026-10-12]
Hardware/3D/SolidWorks/Orbi Assemble.SLDASM
Orbi_Base
Orbi_Joystick
Orbi_Joystick_Spring
Orbi_Battery_803160_REF
TopCopper~Y9tq-0
TopCopper~Y9tq-1
TopCopper~Y9tq-2
TopCopper~Y9tq-3
TopCopper~Y9tq-4
TopCopper~Y9tq-5
TopCopper~Y9tq-6
TopCopper~Y9tq-7
TopCopper~Y9tq-8
TopCopper~Y9tq-9
TopCopper~Y9tq-10
TopCopper~Y9tq-11
TopCopper~Y9tq-12
TopCopper~Y9tq-13
TopCopper~Y9tq-14
TopCopper~Y9tq-15
TopCopper~Y9tq-16
TopCopper~Y9tq-17
TopCopper~Y9tq-18
TopCopper~Y9tq-19
TopCopper~Y9tq-20
TopCopper~Y9tq-21
TopCopper~Y9tq-22
TopCopper~Y9tq-23
TopCopper~Y9tq-24
TopCopper~Y9tq-25
TopCopper~Y9tq-26
TopCopper~Y9tq-27
TopCopper~Y9tq-28
TopCopper~Y9tq-29
TopCopper~Y9tq-30
TopCopper~Y9tq-31
TopCopper~Y9tq-32
TopCopper~Y9tq-33
TopCopper~Y9tq-34
TopCopper~Y9tq-35
TopCopper~Y9tq-36
TopCopper~Y9tq-37
TopCopper~Y9tq-38
TopCopper~Y9tq-39
TopCopper~Y9tq-40
TopCopper~Y9tq-41
TopCopper~Y9tq-42
TopCopper~Y9tq-43
TopCopper~Y9tq-44
TopCopper~Y9tq-45
TopCopper~Y9tq-46
TopCopper~Y9tq-47
BottomCopper~Y9tq-48
BottomCopper~Y9tq-49
BottomCopper~Y9tq-50
BottomCopper~Y9tq-51
BottomCopper~Y9tq-52
BottomCopper~Y9tq-53
BottomCopper~Y9tq-54
BottomCopper~Y9tq-55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
