WilliTourt/Orbi-SpaceMouse/Hardware/3D/SolidWorks/Reference Parts/TopSilkscreen~XFgC.SLDASM

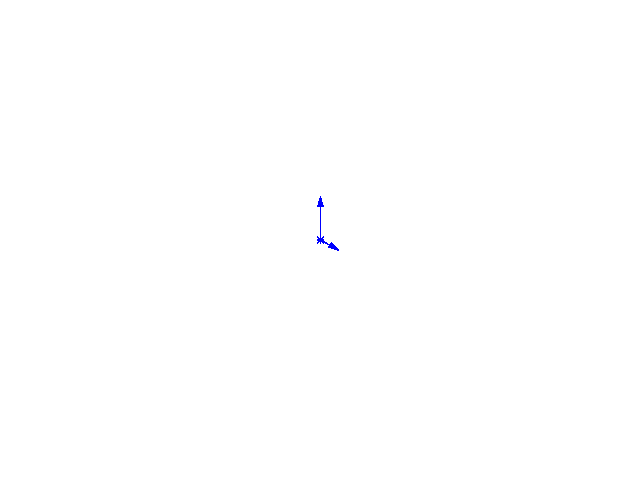
[picture p42: CAD file, 2026-10-08]
Hardware/3D/SolidWorks/Reference Parts/TopSilkscreen~XFgC.SLDASM
TopSilkscreen~XFgC-109
TopSilkscreen~XFgC-110
TopSilkscreen~XFgC-111
TopSilkscreen~XFgC-112
TopSilkscreen~XFgC-113
TopSilkscreen~XFgC-114
TopSilkscreen~XFgC-115
TopSilkscreen~XFgC-116
TopSilkscreen~XFgC-117
TopSilkscreen~XFgC-118
TopSilkscreen~XFgC-119
TopSilkscreen~XFgC-120
TopSilkscreen~XFgC-121
TopSilkscreen~XFgC-122
TopSilkscreen~XFgC-123
TopSilkscreen~XFgC-124
TopSilkscreen~XFgC-125
TopSilkscreen~XFgC-126
TopSilkscreen~XFgC-127
TopSilkscreen~XFgC-128
TopSilkscreen~XFgC-129
TopSilkscreen~XFgC-130
TopSilkscreen~XFgC-131
TopSilkscreen~XFgC-132
TopSilkscreen~XFgC-133
TopSilkscreen~XFgC-134
TopSilkscreen~XFgC-135
TopSilkscreen~XFgC-136
TopSilkscreen~XFgC-137
TopSilkscreen~XFgC-138
TopSilkscreen~XFgC-139
TopSilkscreen~XFgC-140
TopSilkscreen~XFgC-141
TopSilkscreen~XFgC-142
TopSilkscreen~XFgC-143
TopSilkscreen~XFgC-144
TopSilkscreen~XFgC-145
TopSilkscreen~XFgC-146
TopSilkscreen~XFgC-147
TopSilkscreen~XFgC-148
TopSilkscreen~XFgC-149
TopSilkscreen~XFgC-150
TopSilkscreen~XFgC-151
TopSilkscreen~XFgC-152
TopSilkscreen~XFgC-153
TopSilkscreen~XFgC-154
TopSilkscreen~XFgC-155
TopSilkscreen~XFgC-156
TopSilkscreen~XFgC-157
TopSilkscreen~XFgC-158
TopSilkscreen~XFgC-159
TopSilkscreen~XFgC-160
TopSilkscreen~XFgC-161
TopSilkscreen~XFgC-162
TopSilkscreen~XFgC-163
TopSilkscreen~XFgC-164
TopSilkscreen~XFgC-165
TopSilkscreen~XFgC-166
TopSilkscreen~XFgC-167
TopSilkscreen~XFgC-168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
