WilliTourt/Orbi-SpaceMouse/(list of files, cad)

Other CAD files:
Hardware/3D/SolidWorks/Reference Parts/R14~R_0402_1005Metric~R0402_L1.0-W0.5-H0.4~XFgC.SLDASM
Hardware/3D/SolidWorks/Reference Parts/C19~C_0603_1608Metric~C0603_L1.6-W0.8-H0.8~XFgC.SLDASM
Hardware/3D/SolidWorks/Reference Parts/C12~C_0603_1608Metric~C0603_L1.6-W0.8-H0.8~XFgC.SLDASM
Hardware/3D/SolidWorks/Reference Parts/C1~C_0603_1608Metric~C0603_L1.6-W0.8-H0.8~Y9tq.SLDASM
Hardware/3D/SolidWorks/Reference Parts/BottomCopper~XFgC.SLDASM
Hardware/3D/SolidWorks/Reference Parts/R2~R_1206_3216Metric~R1206_L3.2-W1.6-H0.6-~Y9tq.SLDASM
Hardware/3D/SolidWorks/Reference Parts/C3~C_0603_1608Metric~C0603_L1.6-W0.8-H0.8~Y9tq.SLDASM
Hardware/3D/SolidWorks/Reference Parts/R9~R_0603_1608Metric~R0603~XFgC.SLDASM
Hardware/3D/SolidWorks/Reference Parts/C4~C_0603_1608Metric~C0603_L1.6-W0.8-H0.8~Y9tq.SLDASM
Hardware/3D/SolidWorks/Reference Parts/KEY2~SW-SMD_TS24CA~SW-SMD_TS24CA~XFgC.SLDASM
Hardware/3D/SolidWorks/Reference Parts/MAG1~BGA-6_L1.3-W0.8-P0.40-TL_PTMAG3001A2YBGR~BGA-6_L1.3-W0.8-P0.40-TL_PTMAG3001A2YBGR~XFgC.SLDASM
Hardware/3D/SolidWorks/Reference Parts/BottomCopper~Y9tq.SLDASM
Hardware/3D/SolidWorks/Reference Parts/C13~C_0402_1005Metric~C0402_L1.0-W0.5-H0.5~Y9tq.SLDASM
Hardware/3D/SolidWorks/Reference Parts/RGB9~LED-SMD_4P-L3.5-W3.5-TL_WS2812B~LED3535-4P_L3.5-W3.5-H1.9-LS3.7~XFgC.SLDASM
Hardware/3D/SolidWorks/Reference Parts/R15~R_0402_1005Metric~R0402_L1.0-W0.5-H0.4~XFgC.SLDASM
Hardware/3D/SolidWorks/Reference Parts/C14~C_0603_1608Metric~C0603_L1.6-W0.8-H0.8~XFgC.SLDASM
Hardware/3D/SolidWorks/Reference Parts/TopSilkscreen~Y9tq.SLDASM
Hardware/3D/SolidWorks/Reference Parts/BAT~CONN-TH_2P-P2.00_GP01-2001WR-2P~CONN-TH_2P-P2.00_GP01-2001WR-2P~Y9tq.SLDASM
Hardware/3D/SolidWorks/Reference Parts/R6~R_0402_1005Metric~R0402_L1.0-W0.5-H0.4~XFgC.SLDASM
Hardware/3D/SolidWorks/Reference Parts/BOTTOM CONN~HDR-SMD_12P-P2.00-V-M-R2-C6-LS6.5-EH-1~HDR-SMD_12P-P2.00_ZX-PZ2.0-2-6PUW~Y9tq.SLDASM
Hardware/3D/SolidWorks/Reference Parts/R5~R_0402_1005Metric~R0402_L1.0-W0.5-H0.4~Y9tq.SLDASM
Hardware/3D/SolidWorks/Reference Parts/C14~C_0402_1005Metric~C0402_L1.0-W0.5-H0.5~Y9tq.SLDASM
Hardware/3D/SolidWorks/Reference Parts/R4~R_0402_1005Metric~R0402_L1.0-W0.5-H0.4~XFgC.SLDASM
Hardware/3D/SolidWorks/Reference Parts/TopCopper~Y9tq.SLDASM
Hardware/3D/SolidWorks/Reference Parts/MAG3~BGA-6_L1.3-W0.8-P0.40-TL_PTMAG3001A2YBGR~BGA-6_L1.3-W0.8-P0.40-TL_PTMAG3001A2YBGR~XFgC.SLDASM
Hardware/3D/SolidWorks/Reference Parts/C20~C_1206_3216Metric~C1206_L3.2-W1.6-H1.3~XFgC.SLDASM
Hardware/3D/SolidWorks/Reference Parts/R4~R_0603_1608Metric~R0603~Y9tq.SLDASM
Hardware/3D/SolidWorks/Reference Parts/SWC~SW-SMD_MST22D18G2~SW-SMD_MST22D18G2~Y9tq.SLDASM
Hardware/3D/SolidWorks/Reference Parts/C18~C_0402_1005Metric~C0402_L1.0-W0.5-H0.5~Y9tq.SLDASM
Hardware/3D/SolidWorks/Reference Parts/R10~R_0402_1005Metric~R0402_L1.0-W0.5-H0.4~XFgC.SLDASM
Hardware/3D/SolidWorks/Reference Parts/C1~C_0402_1005Metric~C0402_L1.0-W0.5-H0.5~XFgC.SLDASM
Hardware/3D/SolidWorks/Reference Parts/3D_MomBoard.SLDASM
Hardware/3D/SolidWorks/Reference Parts/BottomSilkscreen~Y9tq.SLDASM
Hardware/3D/SolidWorks/Reference Parts/BOTTOM CONN~HDR-SMD_12P-P2.00-V-F-R2-C6-LS6.5-1~HDR-SMD_12P-P2.00-V-F-R2-C6-LS6.5-1~XFgC.SLDASM
Hardware/3D/SolidWorks/Reference Parts/C2~C_0402_1005Metric~C0402_L1.0-W0.5-H0.5~Y9tq.SLDASM
Hardware/3D/SolidWorks/Reference Parts/C8~C_0402_1005Metric~C0402_L1.0-W0.5-H0.5~XFgC.SLDASM
Hardware/3D/SolidWorks/Reference Parts/R3~R_0402_1005Metric~R0402_L1.0-W0.5-H0.4~Y9tq.SLDASM
Hardware/3D/SolidWorks/Reference Parts/R2~R_0402_1005Metric~R0402_L1.0-W0.5-H0.4~XFgC.SLDASM
Hardware/3D/SolidWorks/Reference Parts/C2~C_0402_1005Metric~C0402_L1.0-W0.5-H0.5~XFgC.SLDASM
Hardware/3D/SolidWorks/Reference Parts/R13~R_0402_1005Metric~R0402_L1.0-W0.5-H0.4~XFgC.SLDASM
Hardware/3D/SolidWorks/Reference Parts/TopCopper~XFgC.SLDASM
Hardware/3D/SolidWorks/Reference Parts/R3~R_0402_1005Metric~R0402_L1.0-W0.5-H0.4~XFgC.SLDASM
Hardware/3D/SolidWorks/Reference Parts/C17~C_0603_1608Metric~C0603_L1.6-W0.8-H0.8~XFgC.SLDASM
Hardware/3D/SolidWorks/Reference Parts/R6~R_0402_1005Metric~R0402_L1.0-W0.5-H0.4~Y9tq.SLDASM
Hardware/3D/SolidWorks/Reference Parts/R7~R_0402_1005Metric~R0402_L1.0-W0.5-H0.4~XFgC.SLDASM
Hardware/3D/SolidWorks/Reference Parts/BottomSilkscreen~XFgC.SLDASM
Hardware/3D/SolidWorks/Reference Parts/RGB5~LED-SMD_4P-L3.5-W3.5-TL_WS2812B~LED3535-4P_L3.5-W3.5-H1.9-LS3.7~XFgC.SLDASM
Hardware/3D/SolidWorks/Reference Parts/C15~C_0402_1005Metric~C0402_L1.0-W0.5-H0.5~Y9tq.SLDASM
Hardware/3D/SolidWorks/Reference Parts/C10~C_0603_1608Metric~C0603_L1.6-W0.8-H0.8~XFgC.SLDASM
Hardware/3D/SolidWorks/Reference Parts/C4~C_0402_1005Metric~C0402_L1.0-W0.5-H0.5~XFgC.SLDASM
Hardware/3D/SolidWorks/Reference Parts/MAG2~BGA-6_L1.3-W0.8-P0.40-TL_PTMAG3001A2YBGR~BGA-6_L1.3-W0.8-P0.40-TL_PTMAG3001A2YBGR~XFgC.SLDASM
Hardware/3D/SolidWorks/Reference Parts/C11~C_0603_1608Metric~C0603_L1.6-W0.8-H0.8~XFgC.SLDASM
Hardware/3D/SolidWorks/Reference Parts/R1~R_0402_1005Metric~R0402_L1.0-W0.5-H0.4~XFgC.SLDASM
Hardware/3D/SolidWorks/Reference Parts/C6~C_0402_1005Metric~C0402_L1.0-W0.5-H0.5~XFgC.SLDASM
Hardware/3D/SolidWorks/Reference Parts/C10~C_0402_1005Metric~C0402_L1.0-W0.5-H0.5~Y9tq.SLDASM
Hardware/3D/SolidWorks/Reference Parts/C11~C_0402_1005Metric~C0402_L1.0-W0.5-H0.5~Y9tq.SLDASM
Hardware/3D/SolidWorks/Reference Parts/RGB4~LED-SMD_4P-L3.5-W3.5-TL_WS2812B~LED3535-4P_L3.5-W3.5-H1.9-LS3.7~XFgC.SLDASM
Hardware/3D/SolidWorks/Reference Parts/ESP32-S3-MINI-1~BULETM-SMD_ESP32-S3-MINI-1-N8~BULETM-SMD_ESP32-S3-MINI-1-N8~XFgC.SLDASM
Hardware/3D/SolidWorks/Reference Parts/R8~R_0402_1005Metric~R0402_L1.0-W0.5-H0.4~XFgC.SLDASM
Hardware/3D/SolidWorks/Reference Parts/C17~C_0402_1005Metric~C0402_L1.0-W0.5-H0.5~Y9tq.SLDASM
Hardware/3D/SolidWorks/Reference Parts/NTC~CONN-SMD_2P-P1.00_HX-1.0-2P-WT~CONN-SMD_2P-P1.00_HX-1.0-2P-WT~Y9tq.SLDASM
Hardware/3D/SolidWorks/Reference Parts/R7~R_0402_1005Metric~R0402_L1.0-W0.5-H0.4~Y9tq.SLDASM
Hardware/3D/SolidWorks/Reference Parts/3D_PWR BottomBoard v1.1.SLDASM
Hardware/3D/SolidWorks/Reference Parts/RGB1~LED-SMD_4P-L3.5-W3.5-TL_WS2812B~LED3535-4P_L3.5-W3.5-H1.9-LS3.7~XFgC.SLDASM
Hardware/3D/SolidWorks/Reference Parts/C15~C_0603_1608Metric~C0603_L1.6-W0.8-H0.8~XFgC.SLDASM
Hardware/3D/SolidWorks/Reference Parts/CHGLED~LED_0603_1608Metric~LED-0603_R~Y9tq.SLDASM
Hardware/3D/SolidWorks/Reference Parts/C3~C_0402_1005Metric~C0402_L1.0-W0.5-H0.5~XFgC.SLDASM
Hardware/3D/SolidWorks/Reference Parts/C6~C_0603_1608Metric~C0603_L1.6-W0.8-H0.8~Y9tq.SLDASM
Hardware/3D/SolidWorks/Reference Parts/RGB2~LED-SMD_4P-L3.5-W3.5-TL_WS2812B~LED3535-4P_L3.5-W3.5-H1.9-LS3.7~XFgC.SLDASM
Hardware/3D/SolidWorks/Reference Parts/R11~R_0402_1005Metric~R0402_L1.0-W0.5-H0.4~XFgC.SLDASM
Hardware/3D/SolidWorks/Reference Parts/C12~C_0402_1005Metric~C0402_L1.0-W0.5-H0.5~Y9tq.SLDASM
Hardware/3D/SolidWorks/Reference Parts/U5~QFN-48_L6.0-W6.0-P0.40-TL-EP4.1~QFN-48_L6.0-W6.0-P0.40-TL-EP4.1~Y9tq.SLDASM
Hardware/3D/SolidWorks/Reference Parts/C9~C_0402_1005Metric~C0402_L1.0-W0.5-H0.5~Y9tq.SLDASM
Hardware/3D/SolidWorks/Reference Parts/R1~R_0402_1005Metric~R0402_L1.0-W0.5-H0.4~Y9tq.SLDASM
Hardware/3D/SolidWorks/Reference Parts/C8~C_0603_1608Metric~C0603_L1.6-W0.8-H0.8~Y9tq.SLDASM
Hardware/3D/SolidWorks/Reference Parts/LED~LED_0603_1608Metric~LED0603_Inf~XFgC.SLDASM
Hardware/3D/SolidWorks/Reference Parts/RGB8~LED-SMD_4P-L3.5-W3.5-TL_WS2812B~LED3535-4P_L3.5-W3.5-H1.9-LS3.7~XFgC.SLDASM
Hardware/3D/SolidWorks/Reference Parts/KEY1~SW-SMD_TS24CA~SW-SMD_TS24CA~XFgC.SLDASM
Hardware/3D/SolidWorks/Reference Parts/C19~C_0603_1608Metric~C0603_L1.6-W0.8-H0.8~Y9tq.SLDASM
Hardware/3D/SolidWorks/Reference Parts/C16~C_0402_1005Metric~C0402_L1.0-W0.5-H0.5~Y9tq.SLDASM
Hardware/3D/SolidWorks/Reference Parts/D1~SOD-323_L1.7-W1.3-LS2.5-RD~SOD-323_L1.7-W1.3-LS2.5-FD~Y9tq.SLDASM
Hardware/3D/SolidWorks/Reference Parts/C16~C_0603_1608Metric~C0603_L1.6-W0.8-H0.8~XFgC.SLDASM
Hardware/3D/SolidWorks/Reference Parts/C5~C_0402_1005Metric~C0402_L1.0-W0.5-H0.5~Y9tq.SLDASM
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
