WilliTourt/Orbi-SpaceMouse/(commit log)

2026-10-08 Uploaded 3D Files
    [3D_MomBoard.SLDASM, 3D_PWR BottomBoard v1.1.SLDASM, BAT~CONN-TH_2P-P2.00_GP01-2001WR-2P~CONN-TH_2P-P2.00_GP01-2001WR-2P~Y9tq.SLDASM, BGA-6_L1.3-W0.8-P0.40-TL_PTMAG3001A2YBGR~BGA-6_L1.3-W0.8-P0.40-TL_PTMAG3001A2YBGR~XFgC.SLDPRT, BOTTOM CONN~HDR-SMD_12P-P2.00-V-F-R2-C6-LS6.5-1~HDR-SMD_12P-P2.00-V-F-R2-C6-LS6.5-1~XFgC.SLDASM, BOTTOM CONN~HDR-SMD_12P-P2.00-V-M-R2-C6-LS6.5-EH-1~HDR-SMD_12P-P2.00_ZX-PZ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]
2026-10-08 Uploaded PCB Images
2026-10-08 added pcb 3D images
2026-10-08 uploaded gerber and silkscreen assets
2026-10-12 uploaded interactive bom
2026-10-26 upload pcb netlists
2026-11-13 algorithm progress: cplted LM magnet pose predict
    next: jacobian mat
